ThKattanek/the_pico_retro_tape/docs/the_retro_tape_documentation.odt

ThePicoRetroTape
von Thorsten Kattanek
Letzte Änderung: 05.04.2025

(Befindet sich noch im Aufbau!)

# Einführung

ThePicoRetroTape ist ein Emulator für Retro-Tapesysteme, der mehrere Systeme unterstützen soll. Dieses Projekt wurde entwickelt, um Kassetten Abbilder (Images) von Retrosystemen für die jeweiligen Systeme nutzbar zu machen, ohne das Originale Kassettengerät (Datasette). Außerdem werden hier moderne Speichermedien verwendet (SD-Karte) und auch die Datenübertragung ist Sicherer.

# Funktionsumfang

- Unterstützung für mehrere Retro-Tapesysteme. (momentan nur C64 und kompatible)
- Emulation von Tape-Datenformaten
- Anzeige über TFT LCD Farbdisplay (128x160 1,77‘‘)
- Steuerung mit 4 Tasten (Hoch, Runter, Enter, Play)
- SD-Karten Slot

# Systemanforderungen

# Installation

# Verwendung

# Projektstruktur

- docs/: Dokumentation und Anleitungen
- firmware/: Enthält den Quellcode des Projekts
- hardware/: Enthält die Hardware in einem KiCad Projekt

# Fehlerbehebung

# Lizenz

Dieses Projekt steht unter der GNU GENERAL PUBLIC Lizenz. Details findest du in der Datei LICENSE.

# Kontakt

Webseite: https://www.thorsten-kattanek.de

GitHub: https://github.com/ThKattanek/the_pico_retro_tape
