ThKattanek/the_pico_retro_tape/docs/c64/erster_adapter_breadbord_c64.jpg

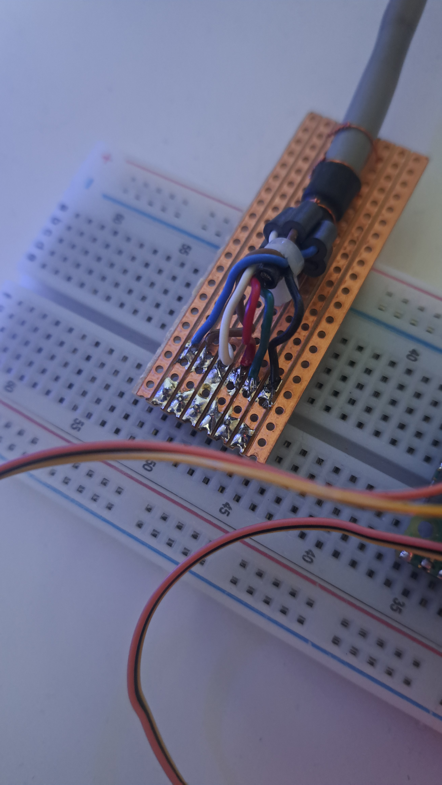
docs/c64/erster_adapter_breadbord_c64.jpg
