ThKattanek/the_pico_retro_tape/docs/todo.txt

C64 TAP einbinden das es 100% aus dem Speicher läuft                         [x]
    - Motor Steuerung                                                        [x]
C64 TAP Record                                                               [ ]
C64 PRG senden, also alle Banddaten müssen erzeugt werden ins Kernal Format  [x]
C64 PRG mit Schnelllader senden                                              [ ]
C64 PRG vor dem senden komprimieren                                          [ ]
C64 T64 senden (ähnlich PRG)                                                 [ ]
D64 untersützen um einzelne Daten zu senden                                  [ ]
Nach Auswahl eines TAP sprung in Countermodus                                [ ]
    (Enter wieder raus, Hoch, Runter = vorwärts + rückwärts)
Cover Modus einbauen - Statt Filebrowser Images anzeigen                     [ ]
Wechsel zwischen Covermodus und Browsermodus                                 [ ]
SD-CARD anbinden                                                             [x]
TFT anbinden                                                                 [x]
1530 Recod ins TAP Format                                                    [ ]
Atari 800 Support                                                            [ ]
.
.
.
