ThKattanek/the_pico_retro_tape/(threads)

Thread 11 (2025-04-24):

Problem if the C64 is on for a longer period of time then the motor status is no longer recognized by the Pico.

ThKattanek, 2025-04-24:
A low level is no longer recognized because the voltage does not go to 0.

ThKattanek, 2025-04-24:
Maybe the resistors for the voltage divider are too high. I'll have to take another look at the C64 circuit diagram.
