ThKattanek/the_pico_retro_tape/docs/schematic/the_pico_retro_tape.pdf

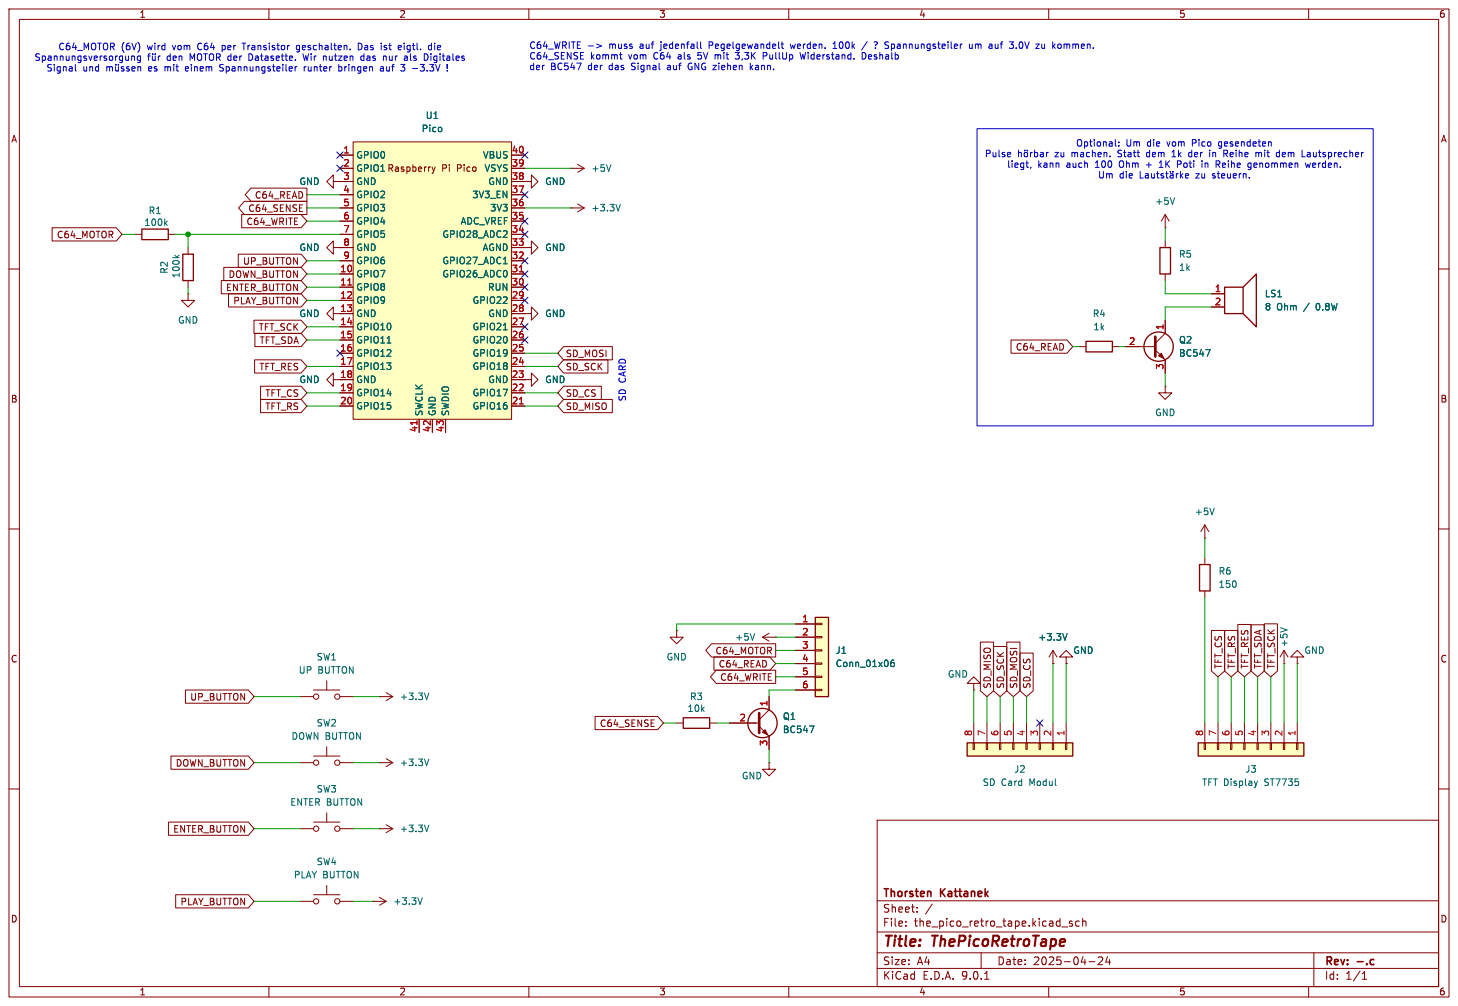
[picture p6: page 1]

der BC547 der das Signal auf GNG ziehen kann. SD CARD
