ThKattanek/the_pico_retro_tape/hardware/ltspice_simulations/c64_tap_pulse_to_audio.asc

Q1: npn; BC547B
R1: res; 1k
R2: res; 8
R3: res; 1k
V1: voltage; 5
V2: voltage; PULSE(0 3.3 0 0 0 500u 1m)
Named nets: 0
.tran 0 20m 0 20u startup
Lautsprecher
