ThKattanek/the_pico_retro_tape/hardware/ltspice_simulations/simulation_sense_signal_control.asc

Q1: npn; BC547B
R1: res; 10k
R2: res; 3.3k
V1: voltage; PULSE(0 3.3 0 0 0 1ms 2ms)
V2: voltage; 5v
Named nets: 0, PICO_SENSE_CONTROL, C64_SENSE_SIGNAL
.tran 0 30ms 0 30us
C64 Intern
