ThKattanek/the_pico_retro_tape/firmware/logo_fw.h

// logo_data erstellt mit data2c von Thorsten Kattanek
const unsigned char logo_data[] ={
0xEC,0xEE,0xED,0xEC,0xEE,0xED,0xEC,0xEE,0xED,0xEC,0xEE,0xED,0xEC,0xEE,0xED,0xEC,0xEE,0xED,0xEC,0xEE,
0xED,0xEC,0xEE,0xED,0xEC,0xEE,0xED,0xEC,0xEE,0xED,0xEC,0xEE,0xED,0xEC,0xEE,0xED,0xEC,0xEE,0xED,0xEC,
0xEE,0xED,0xEC,0xEE,0xED,0xEC,0xEE,0xED,0xEC,0xEE,0xED,0xEC,0xEE,0xED,0xEC,0xEE,0xED,0xEC,0xEE,0xED,
0xEC,0xEE,0xED,0xEC,0xEE,0xED,0xEC,0xEE,0xED,0xEC,0xEE,0xED,0xEC,0xEE,0xED,0xEC,0xEE,0xED,0xEC,0xEE,
0xED,0xEC,0xEE,0xED,0xEC,0xEE,0xED,0xEC,0xEE,0xED,0xEC,0xEE,0xED,0xEC,0xEE,0xED,0xEC,0xEE,0xED,0xEC,
0xEE,0xED,0xEC,0xEE,0xED,0xEC,0xEE,0xED,0xED,0xED,0xED,0xED,0xED,0xED,0xED,0xED,0xED,0xEC,0xEE,0xED,
0xEC,0xEE,0xED,0xED,0xED,0xED,0xED,0xED,0xED,0xED,0xED,0xED,0xED,0xED,0xED,0xED,0xED,0xED,0xED,0xED,
0xED,0xEC,0xEE,0xED,0xEC,0xEE,0xED,0xEC,0xEE,0xED,0xEC,0xEE,0xED,0xEC,0xEE,0xED,0xEC,0xEE,0xED,0xEC,
0xEE,0xED,0xEC,0xEE,0xED,0xEC,0xEE,0xED,0xEC,0xEE,0xED,0xEC,0xEE,0xED,0xEC,0xEE,0xED,0xEC,0xEE,0xED,
0xEC,0xEE,0xED,0xEC,0xEE,0xED,0xEC,0xEE,0xED,0xEC,0xEE,0xED,0xED,0xED,0xED,0xED,0xED,0xED,0xED,0xED,
0xED,0xED,0xED,0xED,0xED,0xED,0xED,0xED,0xED,0xED,0xED,0xED,0xED,0xED,0xED,0xED,0xEC,0xEE,0xED,0xEC,
0xEE,0xED,0xEC,0xEE,0xED,0xEC,0xEE,0xED,0xEC,0xEC,0xEC,0xEC,0xEC,0xEC,0xED,0xED,0xED,0xEC,0xEE,0xED,
0xEC,0xEE,0xED,0xEC,0xEE,0xED,0xEC,0xEE,0xED,0xEC,0xEE,0xED,0xEC,0xEE,0xED,0xEC,0xEE,0xED,0xEC,0xEE,
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
0xEE,0xED,0xEC,0xEE,0xED,0xEC,0xEE,0xED,0xEC,0xEE,0xED,0xEC,0xEE,0xED,0xEC,0xEE,0xED,0xEC,0xEE,0xED,
0xEC,0xEE,0xED,0xEC,0xEE,0xED,0xEC,0xEE,0xED,0xEC,0xEE,0xED,0xEC,0xEE,0xED,0xEC,0xEE,0xED,0xEC,0xEE,
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
};
const int logo_data_length = 61440;
