ThKattanek/the_pico_retro_tape/firmware/file_browser.h

////////////////////////////////////////////////////////
//                                                    //
// ThePicoRetroTape                                   //
// von Thorsten Kattanek                              //
//                                                    //
// #file: file_browser.h                              //
//                                                    //
// https://github.com/ThKattanek/the_pico_retro_tape  //
//                                                    //
//                                                    //
//////////////////////////////////////////////////////// 

#ifndef FILE_BROWSER_H
#define FILE_BROWSER_H

#include <stdio.h>
#include <pico/stdlib.h>
#include <ff.h>
#include "st7735/ST7735_TFT.hpp"

#define MAX_DIR_ENTRYS 16
#define MAX_FILENAME_LENGTH 256
#define MAX_PATH_LENGTH 2048

class FileBrowser {
public:
    FileBrowser(ST7735_TFT* tft, const char* root_path, const char** allowed_extensions = NULL, int num_allowed_extensions = 0);
    ~FileBrowser();

    void set_bg_color(uint16_t color) { bg_color = color; }
    void set_fg_color(uint16_t color) { fg_color = color; }
    void set_sel_color(uint16_t color) { sel_color = color; }
    void set_chars_per_line(int chars) { chars_per_line = chars; }  
    void set_hide_dot_files(bool hide) { hide_dot_files = hide; }
    
    char* GetCurrentPath() { return current_path; }
    char* GetCurrentFile() { return dir_entrys[dir_entrys_pos]; }
    bool CheckFileExtension(const char* ext);

    void DrawPage();
    void Up();
    void Down();
    bool Enter();
    void Back();

private:
    int ReadDirEntrys();
    void DrawLine(int line, bool selected);

    int     current_page = 0;                                       // Current page
    int     current_page_entries = 0;                               // Number of entries on the current page
    char    dir_entrys[MAX_DIR_ENTRYS][MAX_FILENAME_LENGTH + 10];   // Directory entrys
    bool    dir_entrys_is_dir[16];                                  // is true if entry is a directory ; false if entry is a file
    int     dir_entrys_pos;                                         // Position in the directory entrys
    int     dir_entrys_pos_old;                                     // Old position in the directory entrys

    ST7735_TFT* tft;        // TFT Display

    const char** allowed_extensions;            // Erlaubte Dateiendungen
    int num_allowed_extensions;

    bool  hide_dot_files = true;    // Hide dot files
    char* root_path;                // Root path of the file browser
    char* current_path;             // Current path of the file browser
    int dir_level;                  // Directory level 0 = root, 1 <= subdirectory

    int chars_per_line = 21;    

    uint16_t bg_color = 0x0000;
    uint16_t fg_color = 0xFFFF;
    uint16_t sel_color = 0xF800;

};

#endif // FILE_BROWSER_H
