ThKattanek/the_pico_retro_tape/(commit log)

2025-01-12 start hardware
    [the_pico_retro_tape.kicad_pcb, the_pico_retro_tape.kicad_sch]
2025-01-21 update schematic
    [the_pico_retro_tape.kicad_sch]
2025-01-23 firmware: the motor controller has been moved to the c1530class class
2025-01-23 firmware: signal motor_state controlled the send data stream
2025-01-23 schematic: added the sd card modul
    [the_pico_retro_tape.kicad_sch]
2025-01-23 hardware: changed gpios for sd card slot
    [the_pico_retro_tape.kicad_sch]
2025-02-15 hardware: added the tft display st7735 on spi1
    [the_pico_retro_tape.kicad_sch]
2025-02-15 hardware: change tft vcc and led from 3.3v to 5v
    [the_pico_retro_tape.kicad_sch]
2025-02-16 hardware: added 3 buttons for gui
    [the_pico_retro_tape.kicad_sch]
2025-03-06 hardware: added a transistor for pull the sense signal to ground
    [the_pico_retro_tape.kicad_sch]
2025-03-06 firmware: invert logic for sense signal
    [c1530.cpp, the_pico_retro_tape.cpp]
2025-03-06 firmware: update FileBrowser to manage memory for current_path and improve file opening logic
2025-04-12 ci: add GitHub Actions workflow for RaspberryPi Pico C++ CI
2025-04-12 ci: restore RaspberryPi Pico C++ CI workflow
2025-04-12 feat: add Dockerfile and entrypoint script for Pico Build Action
2025-04-13 Add logo display and firmware version to startup screen
    - Introduced a new function `ViewStartScreen` to display a logo and firmware version on the TFT display during startup.
    - Removed unnecessary clock frequency checks and GPIO initializations for buttons.
    - Integrated logo data and version string into the main function for a cleaner startup experience.
2025-04-15 fix: update Commodore device references in README.md
2025-04-15 fix: update Commodore device list in README.md
2025-04-15 fix: update schematic references and properties in the_pico_retro_tape.kicad_sch
    [the_pico_retro_tape.kicad_sch]
2025-04-15 fix: correct GPIO pin assignment for Play Button in README.md
2025-04-15 fix: update PLAY_BUTTON_GPIO assignment and increment version to 0.1.0
    [the_pico_retro_tape.cpp]
2025-04-15 Add various documentation and resources for the project
    - Added logo images in PNG and XCF formats.
    - Included project planning document in ODT format.
    - Added schematic PDF for the Pico Retro Tape.
    - Included comprehensive documentation for the Retro Tape in both ODT and PDF formats.
    - Created a TODO list to track project tasks and features.
2025-04-17 Initialize stdio for printf outputs over the uart interface
2025-04-17 Fix TAP file header reading condition in open_image function
    [c1530.cpp]
2025-04-24 Add motor state logging and restore sleep_us calls in fill_send_buffer_from_file
2025-04-24 hardware: added an optional speaker
    [the_pico_retro_tape.kicad_sch]
2025-04-24 Update schematic references and correct plot directory path
    [the_pico_retro_tape.kicad_sch]
